intositeme/xhp70-driver/README.md

# LED Driver Rev 2b

### AL8871Q IC buck mode driver with ATTiny85 mcu for pwm. NTC Thermistor connected to Attiny85 to control pwm.
