intositeme/xhp70-driver/Shell/Studies_Report_2021-03-04-b.html

Image Width (pixels):

# Study Report

Analyzed File | House V2 v26
Version | Autodesk Fusion 360 (2.0.9849)
Creation Date | 2021-03-04, 23:49:14
Author | isaac.wong

#### Project Properties

Title | Studies
Author | isaac.wong

## Simulation Model 1:1

### Study 2 - Thermal

##### Study Properties

Study Type | Thermal
Last Modification Date | 2021-03-04, 23:46:05

#### Settings

##### General

Contact Tolerance | 0.1 mm
Global Initial Temperature | 20 C

##### Damping

##### Mesh

Average Element Size (% of model size)
Solids | 10
Scale Mesh Size Per Part | No
Average Element Size (absolute value) | -
Element Order | Parabolic
Create Curved Mesh Elements | Yes
Max. Turn Angle on Curves (Deg.) | 60
Max. Adjacent Mesh Size Ratio | 1.5
Max. Aspect Ratio | 10
Minimum Element Size (% of average size) | 20

##### Adaptive Mesh Refinement

Number of Refinement Steps | 0
Results Convergence Tolerance (%) | 20
Portion of Elements to Refine (%) | 10
Results for Baseline Accuracy | Heat Flux

#### Materials

Component | Material | Safety Factor
Carlo 30mm lens v6:1/Lens:1 | Glass | Yield Strength
Shell V5 v9:1 | Aluminum 6061 | Yield Strength
Starboard v11:1/Component1:1/Starboard | Copper | Yield Strength
Starboard v11:1/Component1:1/LED Chip | Copper | Yield Strength
Starboard v11:1/Component1:1/Led Dome | Epoxy Resin | Yield Strength
Lens Cover v2:1 | Steel | Yield Strength
xhp70-driver v3:1/TO-220-3_Horizontal_TabUp:1/SOLID:1 | Steel | Yield Strength

##### Copper

Density | 8.94E-06 kg / mm^3
Young's Modulus | 117500 MPa
Poisson's Ratio | 0.345
Yield Strength | 33.3 MPa
Ultimate Tensile Strength | 210 MPa
Thermal Conductivity | 0.401 W / (mm C)
Thermal Expansion Coefficient | 1.67E-05 / C
Specific Heat | 450 J / (kg C)

##### Steel

Density | 7.85E-06 kg / mm^3
Young's Modulus | 210000 MPa
Poisson's Ratio | 0.3
Yield Strength | 207 MPa
Ultimate Tensile Strength | 345 MPa
Thermal Conductivity | 0.056 W / (mm C)
Thermal Expansion Coefficient | 1.2E-05 / C
Specific Heat | 480 J / (kg C)

##### Glass

Density | 2.18E-06 kg / mm^3
Young's Modulus | 68000 MPa
Poisson's Ratio | 0.19
Yield Strength | 33 MPa
Ultimate Tensile Strength | 33 MPa
Thermal Conductivity | 0.00138 W / (mm C)
Thermal Expansion Coefficient | 7.5E-06 / C
Specific Heat | 750 J / (kg C)

##### Epoxy Resin

Density | 1.14E-06 kg / mm^3
Young's Modulus | 4940 MPa
Poisson's Ratio | 0.39
Yield Strength | 12.4 MPa
Ultimate Tensile Strength | 24 MPa
Thermal Conductivity | 4.68E-04 W / (mm C)
Thermal Expansion Coefficient | 3.98E-05 / C
Specific Heat | 1000 J / (kg C)

##### Aluminum 6061

Density | 2.7E-06 kg / mm^3
Young's Modulus | 68900 MPa
Poisson's Ratio | 0.33
Yield Strength | 275 MPa
Ultimate Tensile Strength | 310 MPa
Thermal Conductivity | 0.167 W / (mm C)
Thermal Expansion Coefficient | 2.36E-05 / C
Specific Heat | 897 J / (kg C)

#### Contacts

##### Bonded

Name

[S] Bonded14 [Component1:1(LED Chip)||Component1:1(Starboard)]

[S] Bonded15 [Component1:1(Led Dome)||Component1:1(LED Chip)]

[S] Bonded16 [Shell V5 v9:1||Component1:1(Starboard)]

[S] Bonded17 [Shell V5 v9:1||SOLID:1]

[S] Bonded18 [Shell V5 v9:1||SOLID:1]

#### Mesh

Type | Nodes | Elements
Solids | 42278 | 23482

#### Load Case1

#####  Solve result of this load case is out of date.

#### Loads

##### Convection1

Type | Convection
Convection Value | 10 W / (m^2 K)
Ambient Temperature | 30 C

###### Selected Entities

For correct interpretation of this image use e.g. IE9, Chrome, Safari, Firefox

##### Internal Heat1

Type | Internal Heat
Internal Heat Value | 21 W

###### Selected Entities

For correct interpretation of this image use e.g. IE9, Chrome, Safari, Firefox

##### Heat Source2

Type | Heat Source
Heat Source Value | 0.5 W

###### Selected Entities

For correct interpretation of this image use e.g. IE9, Chrome, Safari, Firefox

#### Results

##### Result Summary

Name | Minimum | Maximum
Temperature
Temperature | 30 C | 110.2 C
Heat Flux
Total | 2.014E-16 W / mm^2 | 0.3739 W / mm^2
X | -0.1554 W / mm^2 | 0.1448 W / mm^2
Y | -0.01766 W / mm^2 | 0.355 W / mm^2
Z | -0.1744 W / mm^2 | 0.1544 W / mm^2
Thermal Gradient
Total | 5.502E-15 C / mm | 1.753 C / mm
X | -1.446 C / mm | 1.412 C / mm
Y | -0.8853 C / mm | 0.3154 C / mm
Z | -1.158 C / mm | 0.7679 C / mm
Applied Heat Flow
Applied Heat Flow | -1.138E-07 W / mm^2 | 8.164E-07 W / mm^2

##### Temperature

###### Temperature

[C] 30 110.2

For correct interpretation of this image use e.g. IE9, Chrome, Safari, Firefox

Image Width (pixels):
