intositeme/xhp70-driver/Coilcraft-MSS1278.step

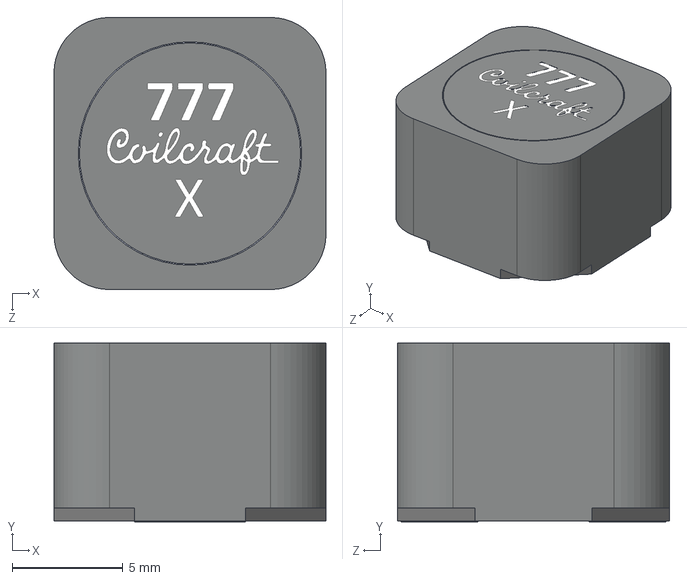
[picture p1: CAD file, 2021-02-27]
Coilcraft-MSS1278.step
12.3 x 8.09 x 12.3 mm
