intositeme/xhp70-driver/BM2B-SRSS-TB.step

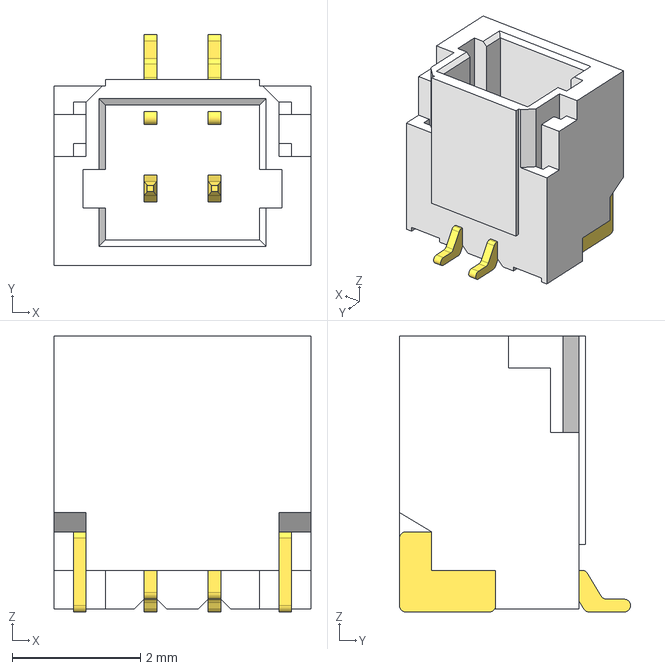
[picture p2: CAD file, 2021-02-27]
BM2B-SRSS-TB.step
4.00 x 3.60 x 4.30 mm
