intositeme/xhp70-driver/TSSOP-16 0.65p 4.4mm Pad.step

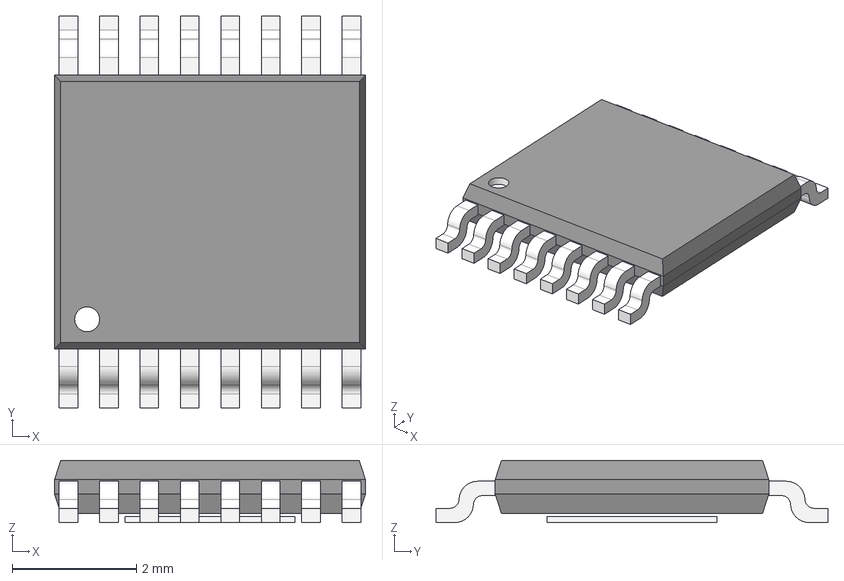
[picture p3: CAD file, 2021-02-27]
TSSOP-16 0.65p 4.4mm Pad.step
5.00 x 6.30 x 1.00 mm
