intositeme/xhp70-driver/User Library-JST - BM06B-SRSS-TB (SH SERIES - 1_0mm PITCH WIRE-TO-BOARD, SMT).igs

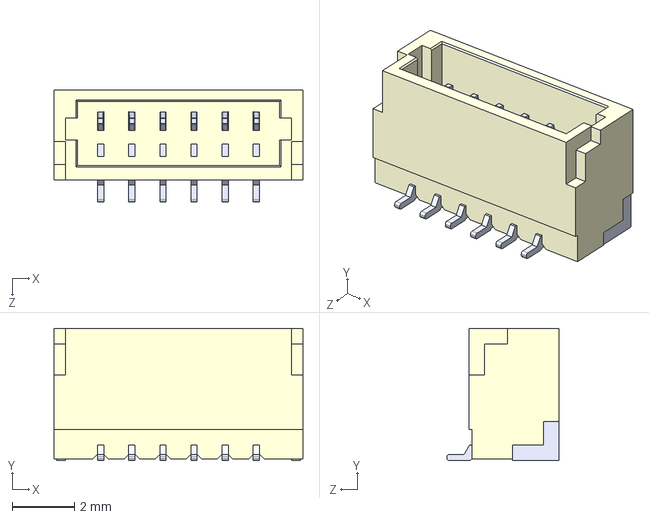
[picture p4: CAD file, 2021-02-27]
User Library-JST - BM06B-SRSS-TB (SH SERIES - 1_0mm PITCH WIRE-TO-BOARD, SMT).igs
8.00 x 4.25 x 3.60 mm
