intositeme/xhp70-driver/xhp70-driver.pdf

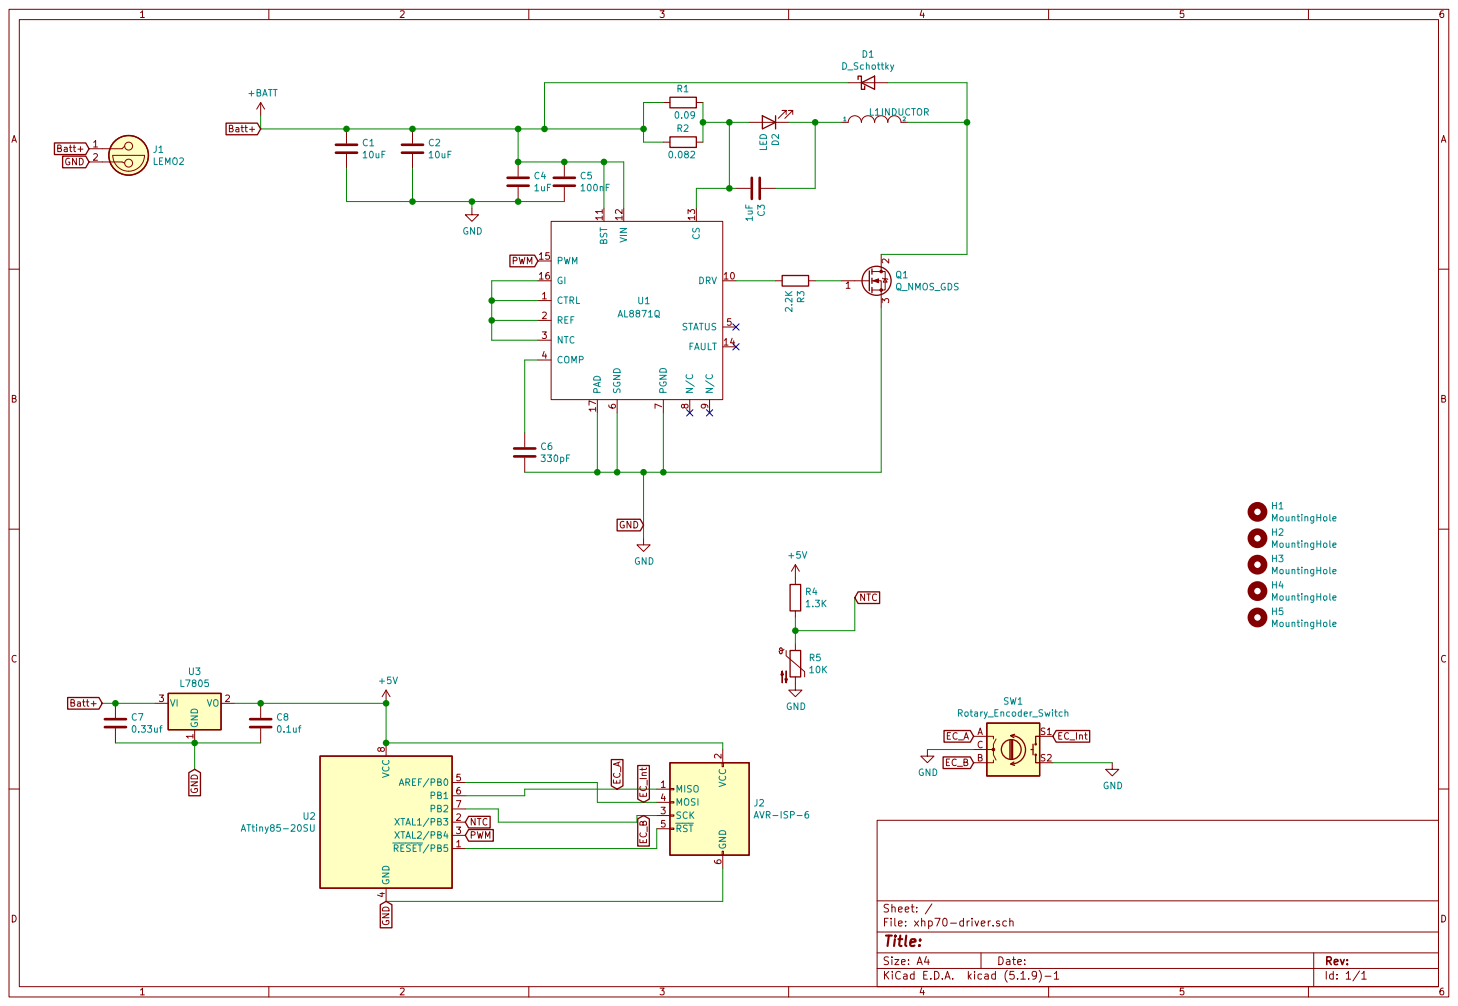
[picture p5: page 1]

2 SCK 3 MOSI 4 RST 5 GND

File: xhp70-driver.sch Sheet: /
Id: 1/1 Title:
