intositeme/xhp70-driver/xhp70-driver.kicad_pcb

## KiCad design xhp70-driver.kicad_pcb (2021-04-21)

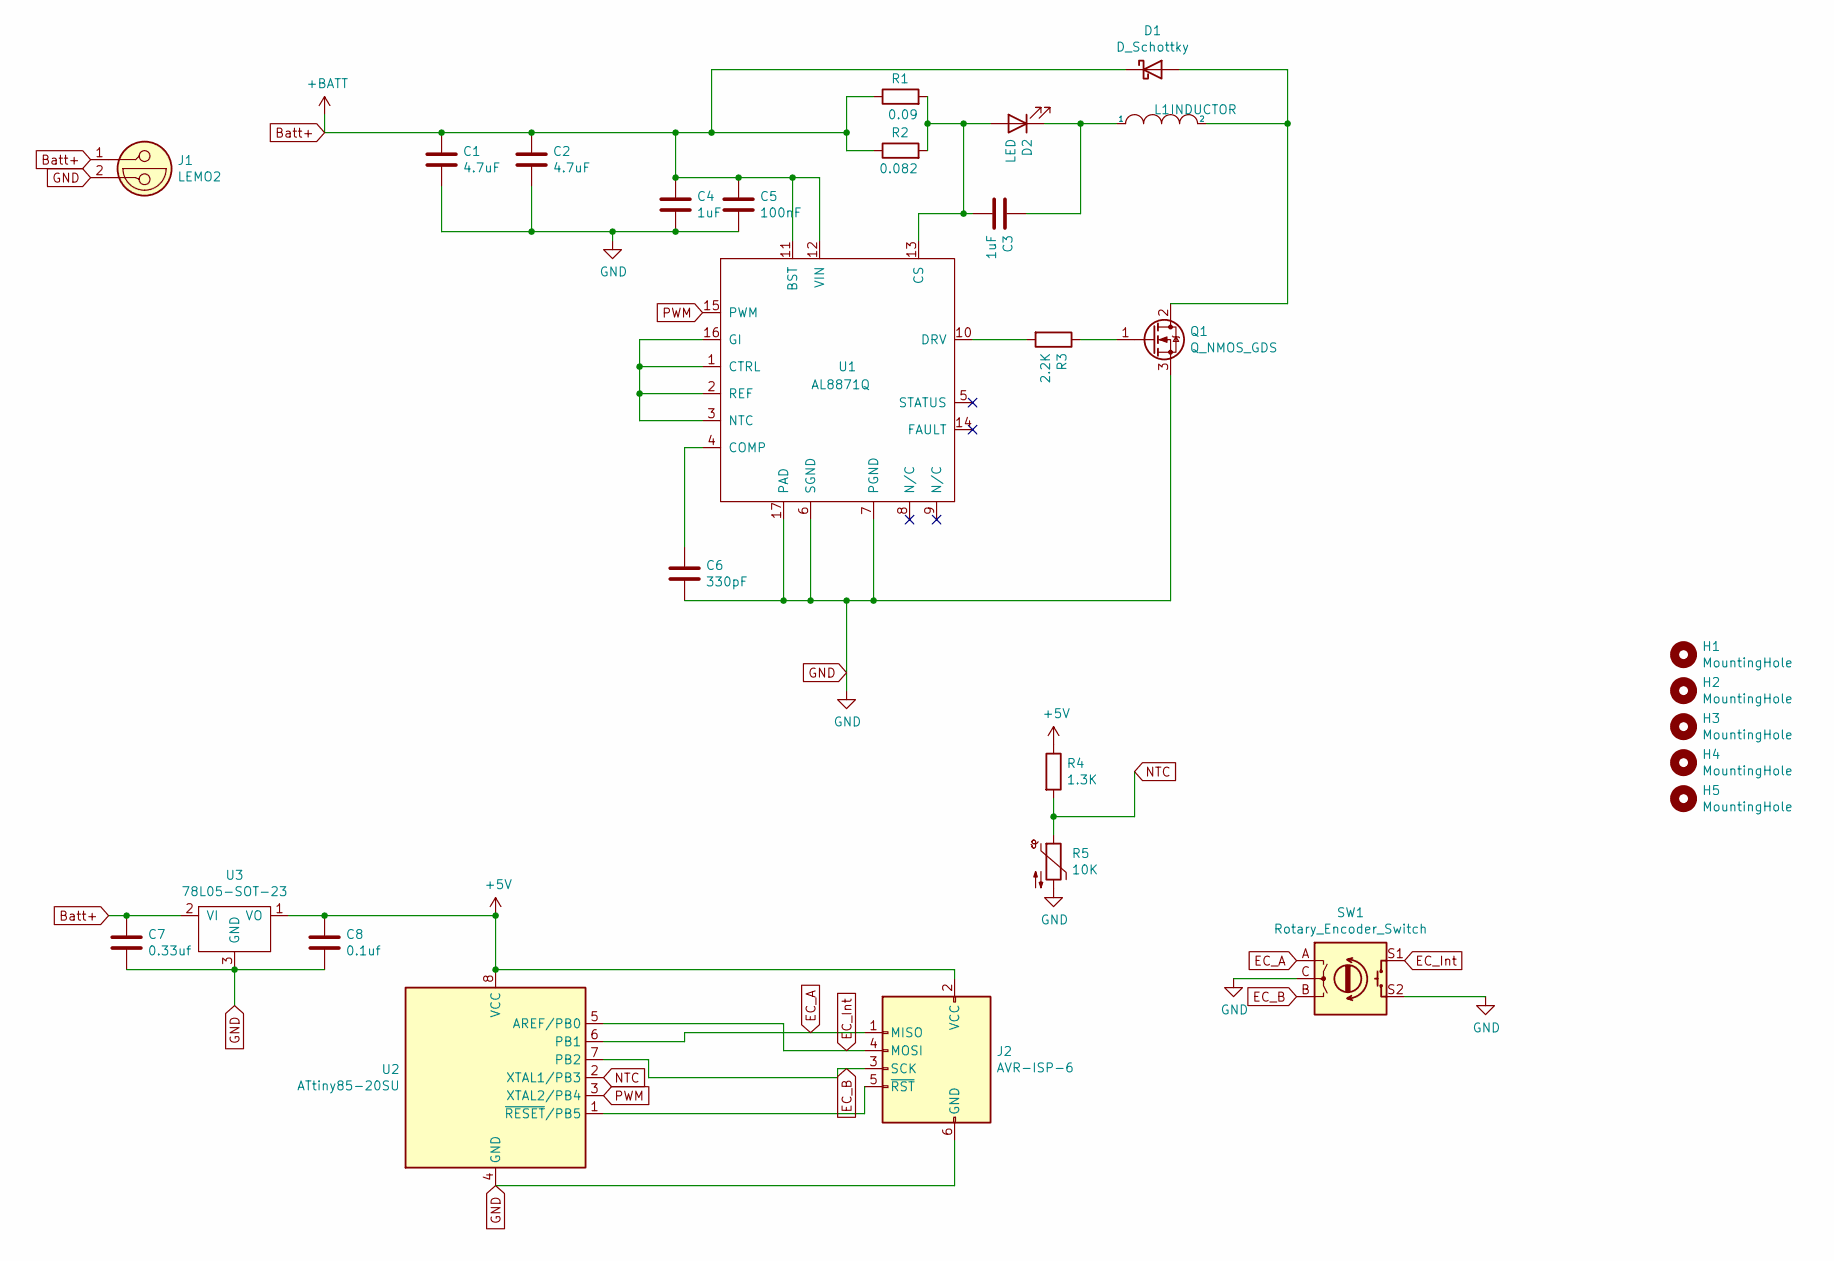
[picture p6: schematic xhp70-driver.sch]

Parts:
C1, C2: 4.7uF; C_1206_3216Metric_Pad1.33x1.80mm_HandSolder
C3, C4: 1uF; C_1206_3216Metric_Pad1.33x1.80mm_HandSolder
C5: 100nF; C_0805_2012Metric
C6: 330pF; C_0805_2012Metric
C7: 0.33uf; C_0805_2012Metric
C8: 0.1uf; C_0805_2012Metric
D1: D_Schottky; TO-220-2_Horizontal_TabUp-no-mounting-hole
D2: LED; TestPoint_2Pad_4.0x4.0mm
H1, H2, H3, H4, H5: MountingHole; MountingHole_2.2mm_M2_ISO7380_Pad
J1: LEMO2; TestPoint_2Pad_4.0x4.0mm
J2: AVR-ISP-6; JST_SH_BM06B-SRSS-TB_1x06-1MP_P1.00mm_Vertical
L1: INDUCTOR; L_12x12mm_H8mm
Q1: Q_NMOS_GDS; TO-220-3_Horizontal_TabUp-no-mounting-hole
R1: 0.09; R_2512_6332Metric
R2: 0.082; R_2512_6332Metric
R3: 2.2K; R_0805_2012Metric
R4: 1.3K; R_0805_2012Metric
R5: 10K; JST_SH_BM02B-SRSS-TB_1x02-1MP_P1.00mm_Vertical
SW1: Rotary_Encoder_Switch
U1: AL8871Q
U2: ATtiny85-20SU; SOIJ-8_5.3x5.3mm_P1.27mm
U3: 78L05-SOT-23; SOT-23

Connections:
+5V: C8.1, J2.2 (VCC), R4.1, U2.8 (VCC), U3.1 (VO)
Batt+: C1.1, C2.1, C4.1, C5.1, C7.1, D1.1 (K), J1.1, R1.1, R2.1, U1.11 (BST), U1.12 (VIN), U3.2 (VI)
EC_A: J2.1 (MISO), SW1.A, U2.6 (PB1)
EC_B: J2.3 (SCK), SW1.B, U2.7 (PB2)
EC_Int: J2.4 (MOSI), SW1.S1, U2.5 (AREF/PB0)
GND: C1.2, C2.2, C4.2, C5.2, C6.2, C7.2, C8.2, J1.2, J2.6 (GND), Q1.3 (S), R5.2, SW1.C, SW1.S2, U1.6 (SGND), U1.7 (PGND), U1.17 (PAD), U2.4 (GND), U3.3 (GND)
NTC: R4.2, R5.1, U2.2 (XTAL1/PB3)
unnamed: C3.1, D2.1 (K), L1.1
unnamed: C3.2, D2.2 (A), R1.2, R2.2, U1.13 (CS)
unnamed: C6.1, U1.4 (COMP)
unnamed: D1.2 (A), L1.2, Q1.2 (D)
unnamed: J2.5 (~RST), U2.1 (~RESET~/PB5)
unnamed: Q1.1 (G), R3.1
unnamed: R3.2, U1.10 (DRV)
unnamed: U1.1 (CTRL), U1.2 (REF), U1.3 (NTC), U1.16 (GI)
PWM: U1.15 (PWM), U2.3 (XTAL2/PB4)

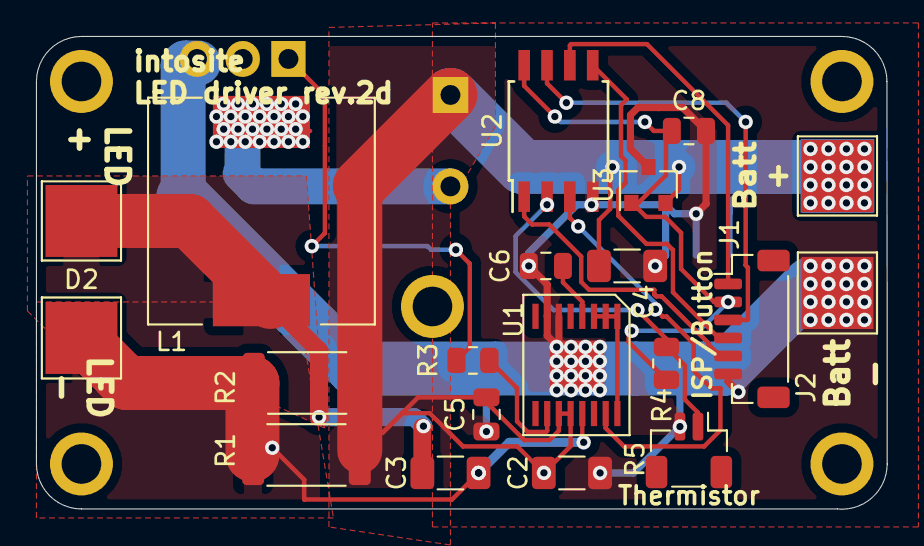
[picture p7: board xhp70-driver.kicad_pcb from above]

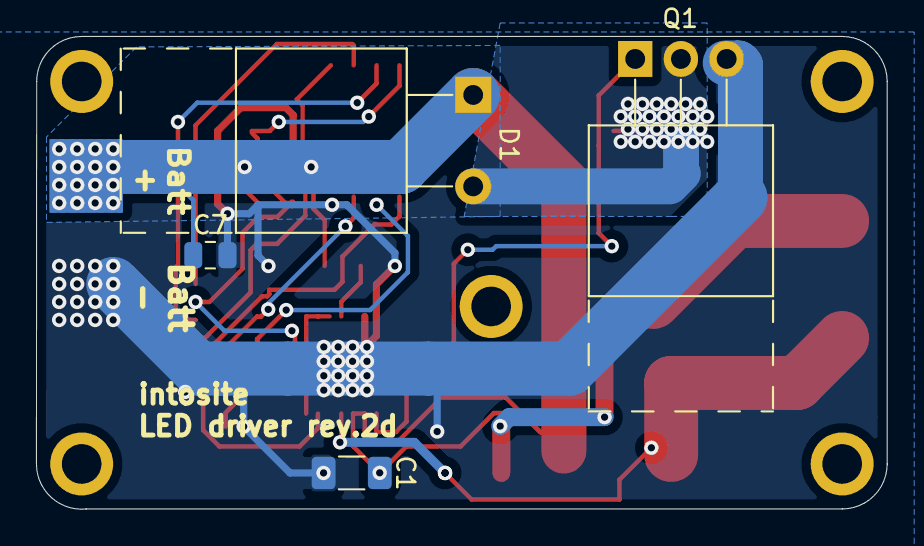
[picture p8: board xhp70-driver.kicad_pcb from below]

Board: 2 copper layers, 47.3 x 26.3 mm, 27 parts (4 on the bottom side), 16 nets.
