intositeme/xhp70-driver/(commit log)

2021-02-17 Initial files
    [xhp70-driver.kicad_pcb, xhp70-driver.sch]
2021-02-17 Layout schematic, created AL8871Q symbol and footprint. Layout PCB.
    Pending values for components and PCB traces.
    [xhp70-driver.kicad_pcb, xhp70-driver.sch]
2021-02-26 Added Attiny85 MCU to control PWM of AL8871Q
    [xhp70-driver.kicad_pcb, xhp70-driver.sch]
2021-02-27 Added components and route connections in xhp70-driver-test-route.pro file
    [xhp70-driver-test-route.kicad_pcb, xhp70-driver.kicad_pcb, xhp70-driver.sch]
2021-02-27 Reposition and changed connector. Reroute traces
    [BM2B-SRSS-TB.step, Coilcraft-MSS1278.step, TSSOP-16 0.65p 4.4mm Pad.step, User Library-JST - BM06B-SRSS-TB (SH SERIES - 1_0mm PITCH WIRE-TO-BOARD, SMT).igs, xhp70-driver-test-route.kicad_pcb, xhp70-driver.kicad_pcb, xhp70-driver.sch]
2021-02-27 Tweak zone fills
    [xhp70-driver.kicad_pcb]
2021-02-27 Added name
    [xhp70-driver-B_Cu.gbr, xhp70-driver-B_Mask.gbr, xhp70-driver-B_Paste.gbr, xhp70-driver-B_SilkS.gbr, xhp70-driver-Edge_Cuts.gbr, xhp70-driver-F_Cu.gbr, xhp70-driver-F_Mask.gbr, xhp70-driver-F_Paste.gbr]
2021-02-27 fixed unconnected tracks
    [xhp70-driver-B_Cu.gbr, xhp70-driver-B_Mask.gbr, xhp70-driver-B_Paste.gbr, xhp70-driver-B_SilkS.gbr, xhp70-driver-Edge_Cuts.gbr, xhp70-driver-F_Cu.gbr, xhp70-driver-F_Mask.gbr, xhp70-driver-F_Paste.gbr]
2021-03-06 LED driver rev.1b - Added decoupling Capacitors for Attiny
    [xhp70-driver-B_Cu.gbr, xhp70-driver-B_Mask.gbr, xhp70-driver-B_Paste.gbr, xhp70-driver-B_SilkS.gbr, xhp70-driver-Edge_Cuts.gbr, xhp70-driver-F_Cu.gbr, xhp70-driver-F_Mask.gbr, xhp70-driver-F_Paste.gbr]
2021-03-07 Rev 2a - route NTC Thermistor to Attiny to control output
    [xhp70-driver-B_Cu.gbr, xhp70-driver-B_Mask.gbr, xhp70-driver-B_Paste.gbr, xhp70-driver-B_SilkS.gbr, xhp70-driver-Edge_Cuts.gbr, xhp70-driver-F_Cu.gbr, xhp70-driver-F_Mask.gbr, xhp70-driver-F_Paste.gbr]
2021-03-16 L7805 schematic pinout is wrong. Needs reroute. `
    [xhp70-driver-B_Cu.gbr, xhp70-driver-B_Mask.gbr, xhp70-driver-B_Paste.gbr, xhp70-driver-B_SilkS.gbr, xhp70-driver-Edge_Cuts.gbr, xhp70-driver-F_Cu.gbr, xhp70-driver-F_Mask.gbr, xhp70-driver-F_Paste.gbr]
2021-03-16 Updated routing and added thicker traces
    [xhp70-driver-B_Cu.gbr, xhp70-driver-B_Mask.gbr, xhp70-driver-B_Paste.gbr, xhp70-driver-B_SilkS.gbr, xhp70-driver-Edge_Cuts.gbr, xhp70-driver-F_Cu.gbr, xhp70-driver-F_Mask.gbr, xhp70-driver-F_Paste.gbr]
2021-03-17 Redo. Same as rev.2b
    [xhp70-driver.kicad_pcb, xhp70-driver.sch]
2021-04-12 Added interactive bom
2021-04-21 Changed LDO to 78L05 linear voltage regulator
    [xhp70-driver-B_Cu.gbr, xhp70-driver-B_Mask.gbr, xhp70-driver-B_Paste.gbr, xhp70-driver-B_SilkS.gbr, xhp70-driver-Edge_Cuts.gbr, xhp70-driver-F_Cu.gbr, xhp70-driver-F_Mask.gbr, xhp70-driver-F_Paste.gbr]
2021-04-21 Revised sense resistor placement
    [xhp70-driver-B_Cu.gbr, xhp70-driver-B_Mask.gbr, xhp70-driver-B_Paste.gbr, xhp70-driver-B_SilkS.gbr, xhp70-driver-Edge_Cuts.gbr, xhp70-driver-F_Cu.gbr, xhp70-driver-F_Mask.gbr, xhp70-driver-F_Paste.gbr]
